UWCubeSat/bonk-electronics/containment-inter/ESQ-105-13-L-D.stp

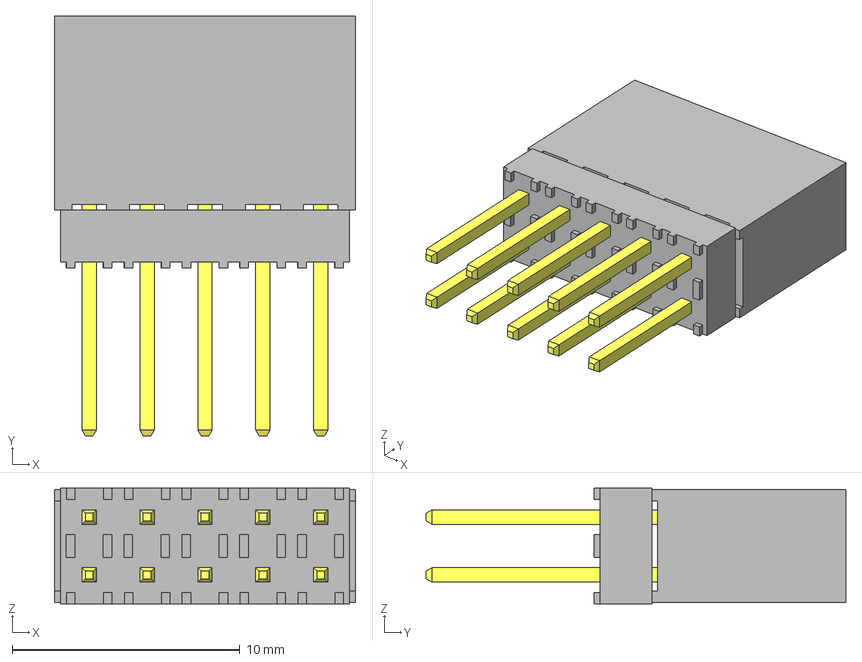
[picture p1: CAD file, 2020-08-15]
containment-inter/ESQ-105-13-L-D.stp
13.2 x 18.4 x 5.08 mm
_ESQ-105-13-L-D_socket
_ESQ-105-13-L-D_pins
_ESQ-105-13-G-D-LL_bpins
