UWCubeSat/bonk-electronics/spaceduino-dummy-experiment/usb-type-b.stp

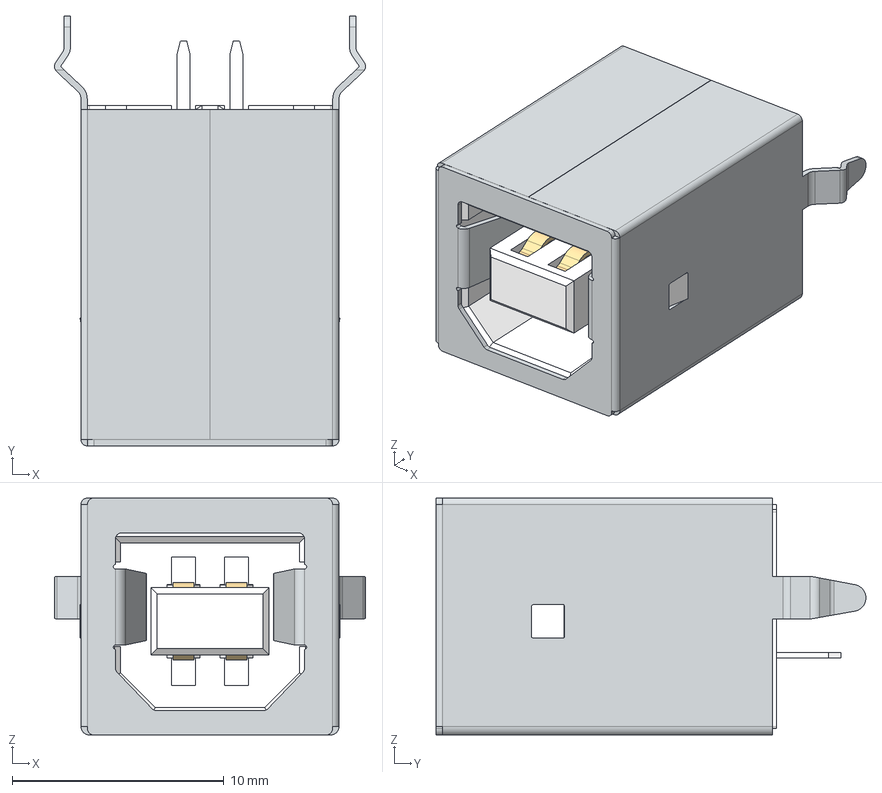
[picture p2: CAD file, 2020-07-03]
spaceduino-dummy-experiment/usb-type-b.stp
14.7 x 20.3 x 11.2 mm
61400413321_Insulator
61400413321_Pin x 2
61400413321_Pin_2 x 2
61400413321_Shielding
