UWCubeSat/bonk-electronics/spaceduino/spaceduino.kicad_pcb

## KiCad design spaceduino/spaceduino.kicad_pcb (2020-12-20)

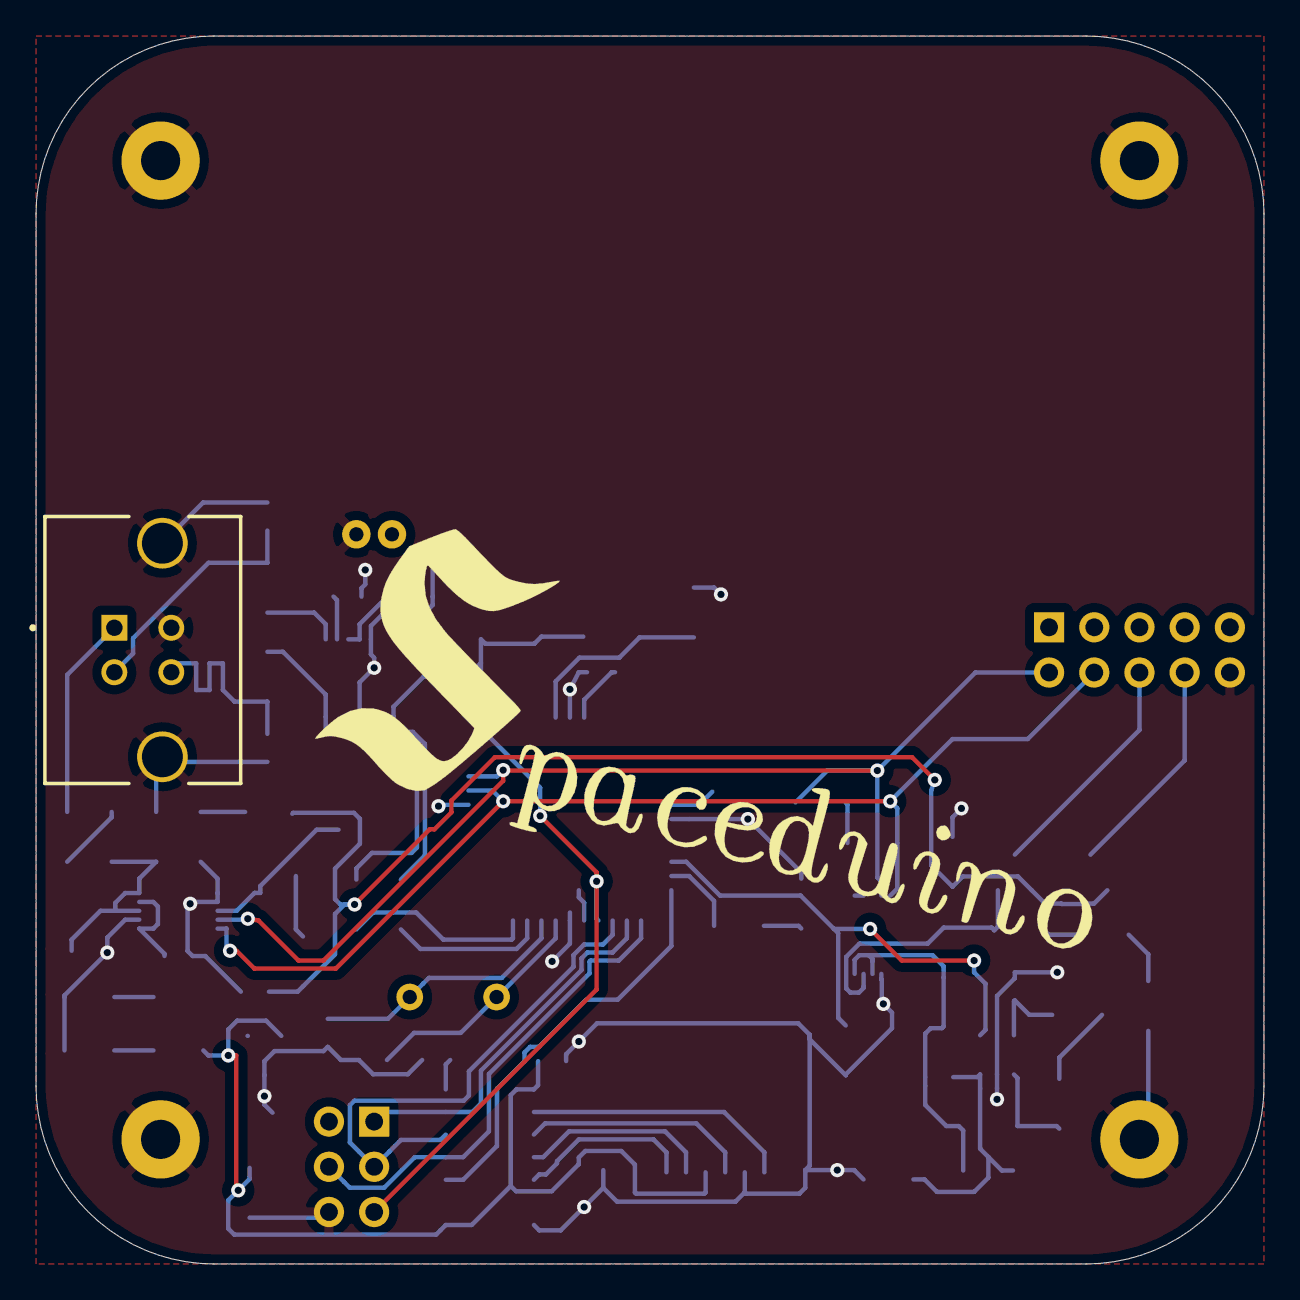
[picture p3: board spaceduino.kicad_pcb from above]

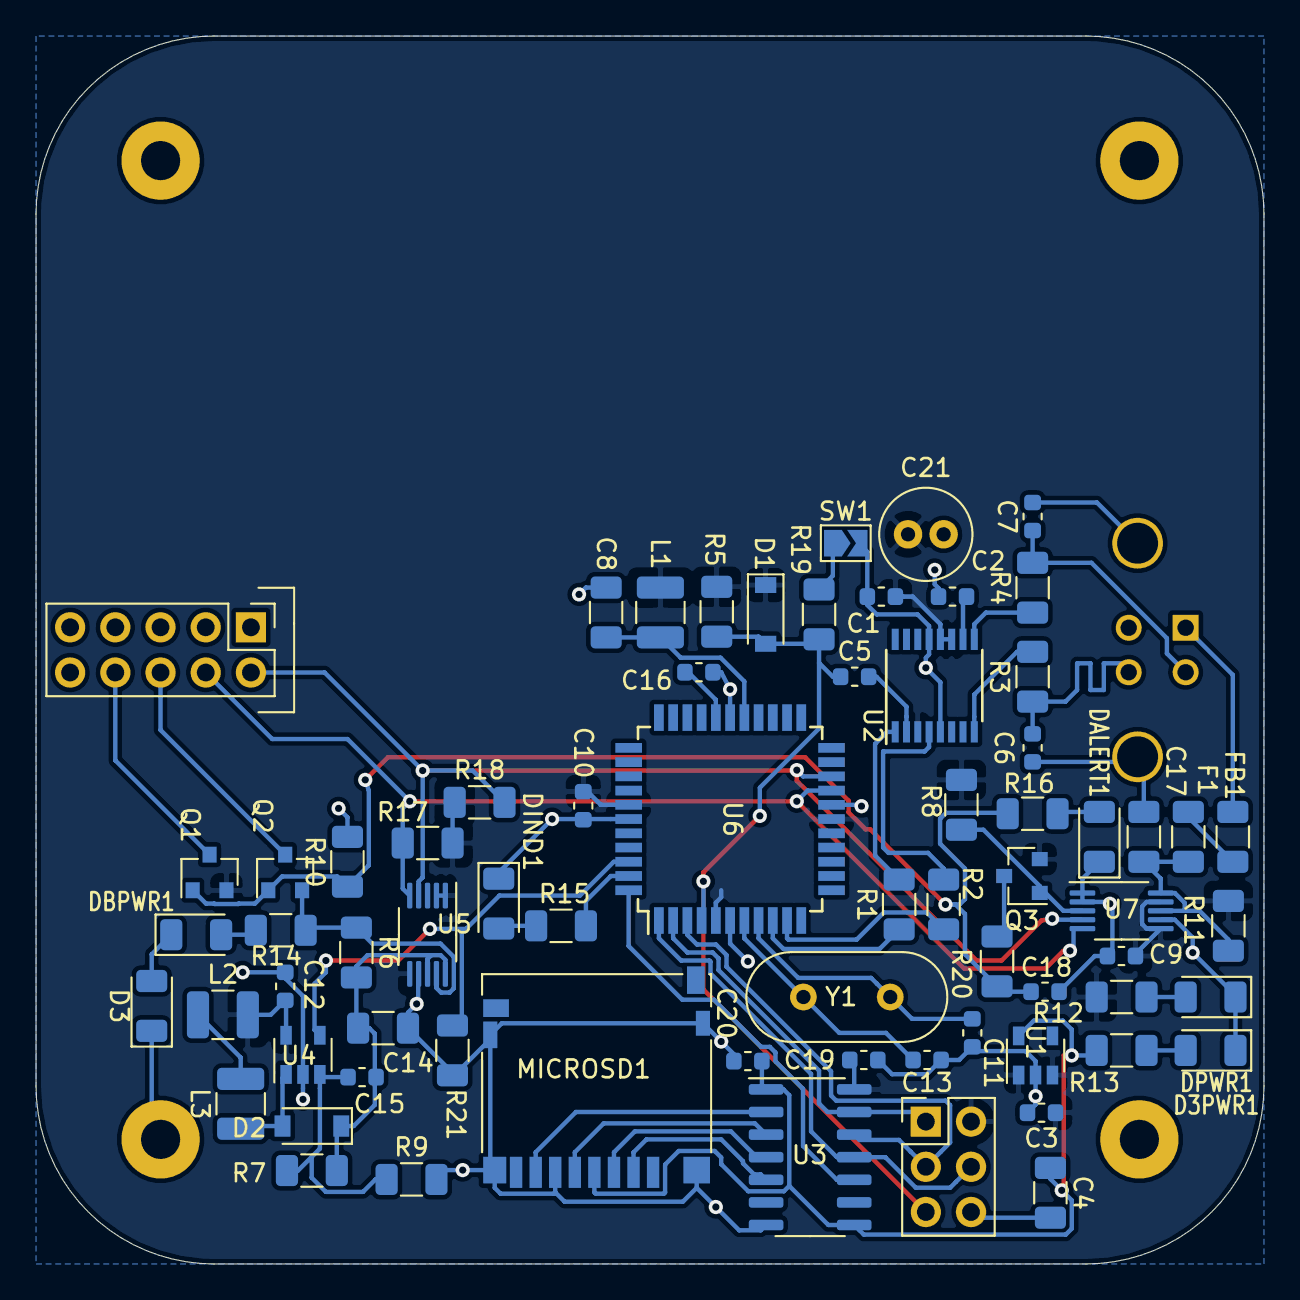
[picture p4: board spaceduino.kicad_pcb from below]

Board: 2 copper layers, 69.0 x 69.0 mm, 76 parts (70 on the bottom side), 50 nets.

Parts:
C1, C2, C3, C5, C9, C10, C12, C16, C19, C20: .1uF; C_0603_1608Metric
C4: 1uF; C_1206_3216Metric
C6, C7: 47pF; C_0603_1608Metric
C8, C14, C17: 10uF; C_1206_3216Metric
C11, C13: 22pF; C_0603_1608Metric
C15: 1.5nF; C_0603_1608Metric
C18: 10uF; C_0603_1608Metric
C21: 100uF; C_Radial_D5.0mm_H11.0mm_P2.00mm
D1: D; D_SOD-123
D2: D_Schottky; D_SOD-123
D3, D3PWR1: LED; LED_1206_3216Metric
DALERT1: LED; LED_1206_3216Metric
DBPWR1: LED; LED_1206_3216Metric
DIND1: LED; LED_1206_3216Metric
DPWR1: LED; LED_1206_3216Metric
F1: 1A; Fuse_1206_3216Metric
FB1: Ferrite_Bead; L_1206_3216Metric
H1, H2, H3, H4: MountingHole_Pad; MountingHole_2.2mm_M2_Pad
J1: USB_B; usb-type-b
J3: JICSP; PinHeader_2x03_P2.54mm_Vertical
J4: Conn_02x05_Odd_Even; PinHeader_2x05_P2.54mm_Vertical
L1: L; L_1210_3225Metric
L2, L3: 10uH; L_1210_3225Metric
LOGO1: Logo_Open_Hardware_Small; spaceduino-logo
MICROSD1: Micro_SD_Card_Det; microSD_HC_Hirose_DM3D-SF
Q1, Q2, Q3: BSS84; SOT-23
R1, R2: 1k; R_1206_3216Metric
R3, R4: 27; R_1206_3216Metric
R5, R8, R21: 10k; R_1206_3216Metric
R6, R11: 50m; R_1206_3216Metric
R7: 13k; R_1206_3216Metric
R9, R12, R15, R16: 1.5k; R_1206_3216Metric
R10: 36k; R_1206_3216Metric
R13: 470; R_1206_3216Metric
R14: 5.6k; R_1206_3216Metric
R17, R18: 3.3k; R_1206_3216Metric
R19, R20: 100; R_1206_3216Metric
SW1: SW_SPST; SolderJumper-2_P1.3mm_Open_TrianglePad1.0x1.5mm
U1: TLV70030_SOT23-5; SOT-23-5
U2: FT230XS; SSOP-16_3.9x4.9mm_P0.635mm
U3: TXB0104D; SOIC-14_3.9x8.7mm_P1.27mm
U4: LM27313XMF; SOT-23-5
U5, U7: INA226; VSSOP-10_3x3mm_P0.5mm
U6: ATmega1284P-AU; TQFP-44_10x10mm_P0.8mm
Y1: Crystal; Crystal_HC49-U_Vertical

Connections:
2_boost_en: R21.1, U4.4, U6.42
3: R15.1, U6.43
4_sd_ss: U3.10, U6.44
5_spi_mosi: J3.4, U3.11, U6.1
6_spi_miso: J3.1, U3.13, U6.2
7_spi_sck: J3.3, U3.12, U6.3
+3V0: C4.1, C20.1, MICROSD1.4, R13.1, U1.5, U3.1, U3.8
+5V: C1.1, C3.1, C9.1, C10.1, C12.1, C19.1, C21.1, D1.1, J3.2, L1.1, L2.2, Q1.2, Q3.2, R5.1, R8.1, R11.1, R12.1, R17.1, R18.1, U1.1, U1.3, U2.3, U2.11, U2.12, U3.14, U4.5, U5.1, U5.2, U5.6, U6.5, U6.17, U6.38, U7.6, U7.9
GND: C1.2, C2.1, C3.2, C4.2, C6.2, C7.2, C8.2, C9.2, C10.2, C11.2, C12.2, C13.2, C14.2, C16.2, C17.2, C18.2, C19.2, C20.2, C21.2, D3.1, D3PWR1.1, DALERT1.1, DIND1.1, DPWR1.1, H1.1, H2.1, H3.1, H4.1, J1.4, J1.5, J3.6, J4.10, MICROSD1.6, MICROSD1.11, R9.2, R10.2, R21.2, SW1.2, U1.2, U2.5, U2.13, U3.7, U4.2, U5.7, U6.6, U6.18, U6.28, U6.39, U7.1, U7.2, U7.7
unnamed: C2.2, U2.10
unnamed: C5.2, U2.2
unnamed: C8.1, L1.2, U6.27
unnamed: C11.1, U6.8, Y1.1
unnamed: C13.1, U6.7, Y1.2
unnamed: C14.1, C15.1, D2.1, R6.2, R7.1, U5.8, U5.10
unnamed: C15.2, R7.2, R9.1, U4.3
unnamed: C16.1, U6.29
unnamed: C17.1, F1.1, R11.2, U7.8, U7.10
unnamed: D2.2, L3.1, U4.1
unnamed: D3.2, DBPWR1.1
unnamed: D3PWR1.2, R13.2
unnamed: DALERT1.2, R16.2
unnamed: DBPWR1.2, R14.2
unnamed: DIND1.2, R15.2
unnamed: DPWR1.2, R12.2
unnamed: F1.2, FB1.2
unnamed: J4.6, Q2.3
unnamed: J4.8, Q1.3
unnamed: L2.1, L3.2
unnamed: MICROSD1.2, U3.5
unnamed: MICROSD1.3, U3.4
unnamed: MICROSD1.5, U3.3
unnamed: MICROSD1.7, U3.2
unnamed: Q3.1, R8.2, U7.3
unnamed: Q3.3, R20.2
unnamed: R1.2, U2.1
unnamed: R2.2, U2.4
unnamed: R3.1, U2.8
unnamed: R4.1, U2.9
unnamed: R19.1, SW1.1
VDDF: Q2.2, R6.1, R14.1, U5.9
current_trip: C18.1, Q1.1, Q2.1, R10.1, R16.1, R20.1
d+: C6.1, J1.3, R3.2
d-: C7.1, J1.2, R4.2
i2c_scl: J4.4, R17.2, U5.5, U6.19, U7.5
i2c_sda: J4.2, R18.2, U5.4, U6.20, U7.4
rxd0: R1.1, U6.9
txd0: R2.1, U6.10
vusb: FB1.1, J1.1
~reset: C5.1, D1.2, J3.5, R5.2, R19.2, U6.4
