UWCubeSat/bonk-electronics/containment-simple/containment-simple.kicad_pcb

## KiCad design containment-simple/containment-simple.kicad_pcb (2020-12-20)

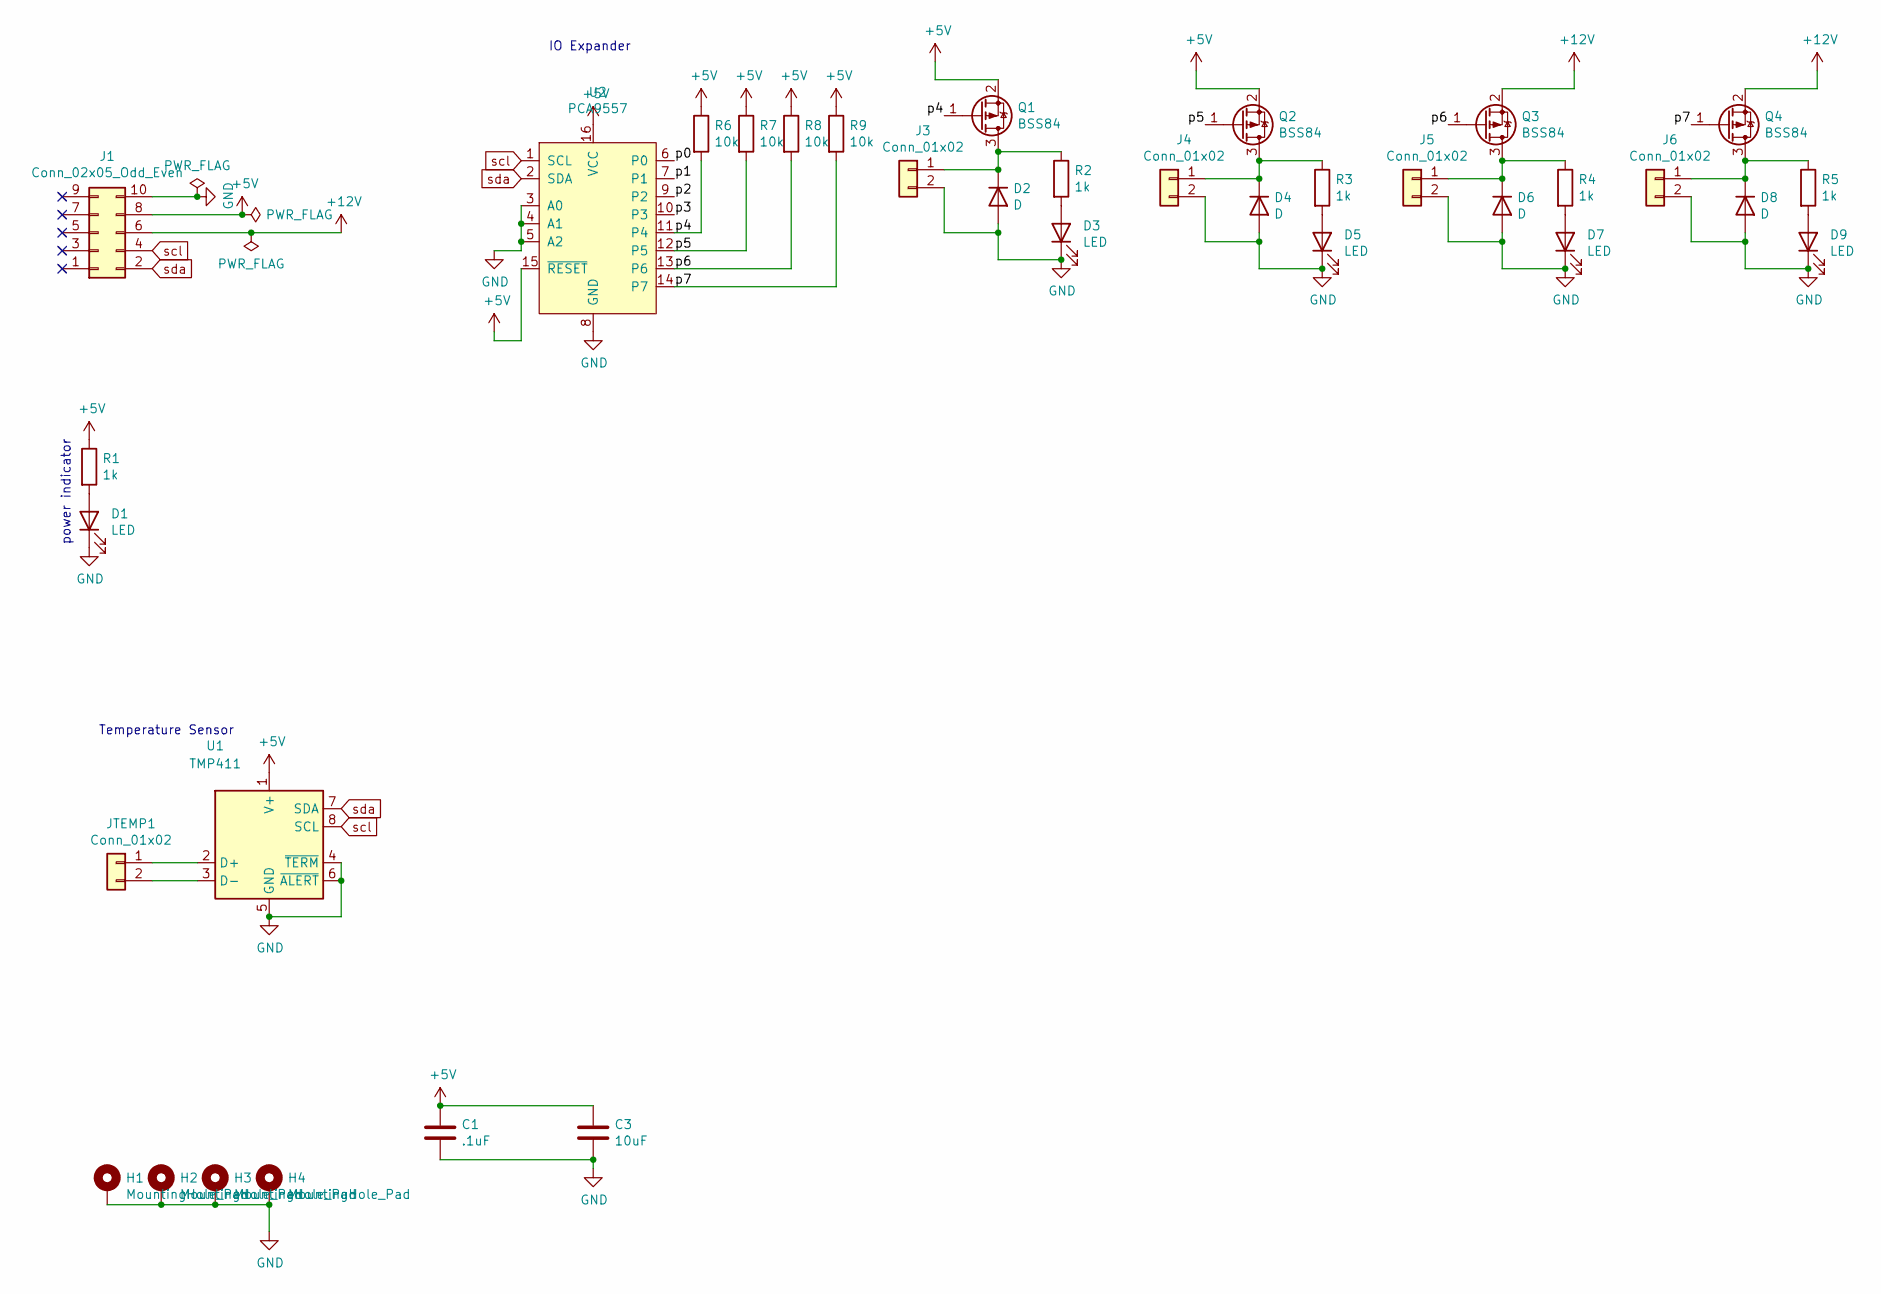
[picture p5: schematic containment-simple.sch]

Parts:
C1: .1uF; C_0603_1608Metric; LCSC C77055
C3: 10uF; C_1206_3216Metric; LCSC C14860
D1, D3, D5, D7, D9: LED; LED_1206_3216Metric; LCSC C264549
D2, D4, D6, D8: D; D_SOD-123; LCSC C222352
H1, H2, H3, H4: MountingHole_Pad; MountingHole_2-56_ExtraClearance
J1: Conn_02x05_Odd_Even; PinHeader_2x05_P2.54mm_Vertical
J3, J4, J5, J6: Conn_01x02; PinHeader_1x02_P2.54mm_Vertical
JTEMP1: Conn_01x02; PinHeader_1x02_P2.54mm_Vertical
Q1, Q2, Q3, Q4: BSS84; SOT-23; LCSC C508197
R1, R2, R3, R4, R5: 1k; R_0603_1608Metric; LCSC C50069
R6, R7, R8, R9: 10k; R_0603_1608Metric; LCSC C491175
U1: TMP411; VSSOP-8_3.0x3.0mm_P0.65mm; LCSC C475495
U2: PCA9557; TSSOP-16_4.4x5mm_P0.65mm; LCSC C141380

Connections:
+5V: C1.1, C3.1, J1.8, Q1.2 (S), Q2.2 (S), R1.1, R6.1, R7.1, R8.1, R9.1, U1.1 (V+), U2.15 (~RESET), U2.16 (VCC)
+12V: J1.6, Q3.2 (S), Q4.2 (S)
/p0: U2.6 (P0)
/p1: U2.7 (P1)
/p2: U2.9 (P2)
/p3: U2.10 (P3)
/p4: Q1.1 (G), R6.2, U2.11 (P4)
/p5: Q2.1 (G), R7.2, U2.12 (P5)
/p6: Q3.1 (G), R8.2, U2.13 (P6)
/p7: Q4.1 (G), R9.2, U2.14 (P7)
GND: C1.2, C3.2, D1.1 (K), D2.2 (A), D3.1 (K), D4.2 (A), D5.1 (K), D6.2 (A), D7.1 (K), D8.2 (A), D9.1 (K), H1.1, H2.1, H3.1, H4.1, J1.10, J3.2, J4.2, J5.2, J6.2, U1.4 (~TERM), U1.5 (GND), U1.6 (~ALERT), U2.3 (A0), U2.4 (A1), U2.5 (A2), U2.8 (GND)
unnamed: D1.2 (A), R1.2
unnamed: D2.1 (K), J3.1, Q1.3 (D), R2.1
unnamed: D3.2 (A), R2.2
unnamed: D4.1 (K), J4.1, Q2.3 (D), R3.1
unnamed: D5.2 (A), R3.2
unnamed: D6.1 (K), J5.1, Q3.3 (D), R4.1
unnamed: D7.2 (A), R4.2
unnamed: D8.1 (K), J6.1, Q4.3 (D), R5.1
unnamed: D9.2 (A), R5.2
unnamed: JTEMP1.1, U1.2 (D+)
unnamed: JTEMP1.2, U1.3 (D-)
scl: J1.4, U1.8 (SCL), U2.1 (SCL)
sda: J1.2, U1.7 (SDA), U2.2 (SDA)

Notes on the sheet:
power indicator
Temperature Sensor
IO Expander

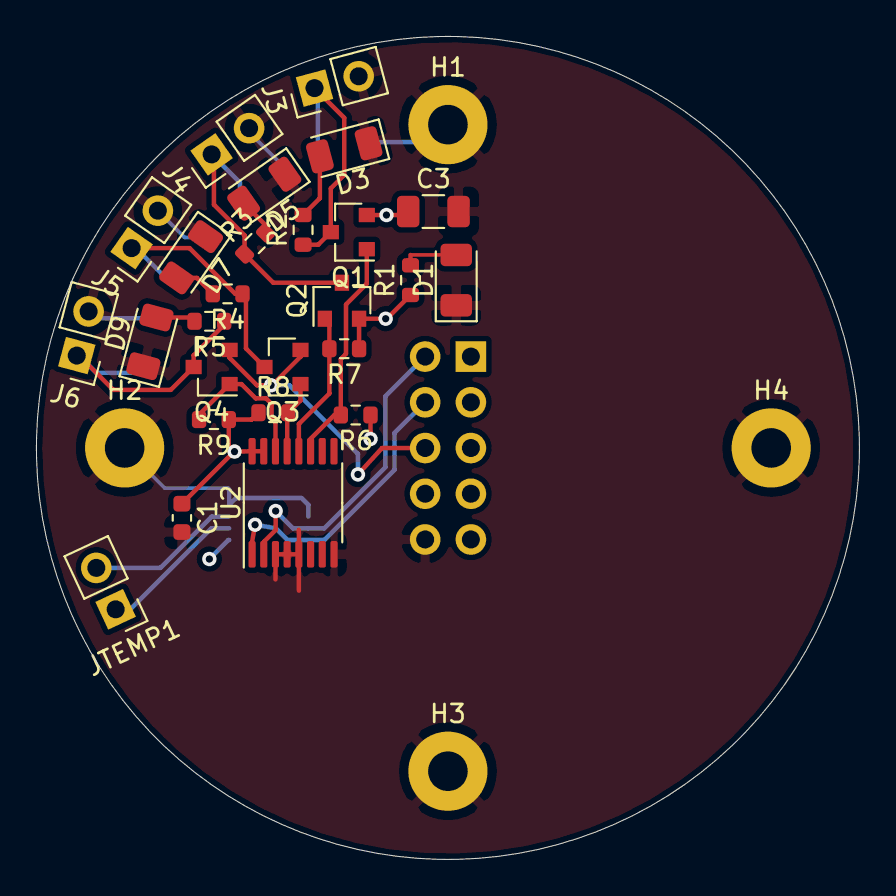
[picture p6: board containment-simple.kicad_pcb from above]

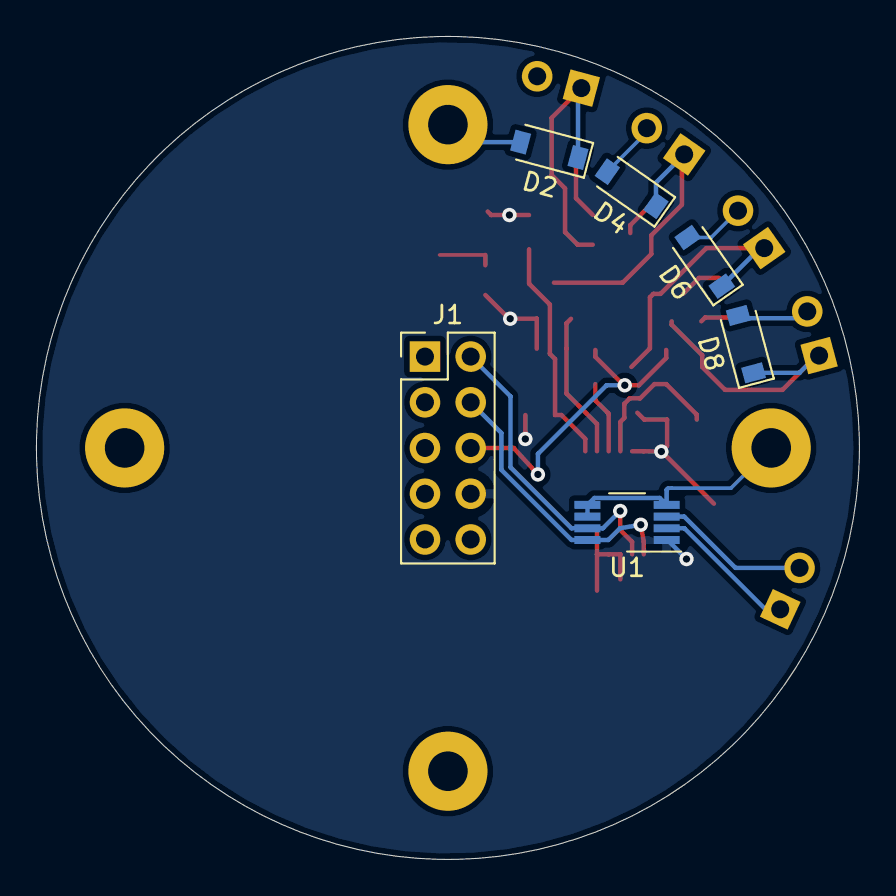
[picture p7: board containment-simple.kicad_pcb from below]

Board: 2 copper layers, 45.7 x 45.7 mm, 36 parts (6 on the bottom side), 20 nets.
