UWCubeSat/bonk-electronics/(commit log)

2020-07-27 containment inter
    [containment-inter.kicad_pcb, containment-inter.sch]
2020-07-27 containment simple mostly done
    [containment-simple.kicad_pcb, containment-simple.sch]
2020-07-27 spaceduino simple finished
    [spaceduino.kicad_pcb, spaceduino.sch]
2020-07-28 spaceduino Rev. 1
    [spaceduino.kicad_pcb, spaceduino.sch]
2020-07-28 jk, /this/ is the spaceduino 1.0! (actually, just look at git tags)
    [spaceduino.kicad_pcb, spaceduino.sch]
2020-07-28 ok, flipped a mosfet, NOW im done
    [spaceduino.kicad_pcb, spaceduino.sch]
2020-08-15 dummy experiment versions, set up .gitignore
    [ESQ-105-13-L-D.stp, containment-inter.kicad_pcb, containment-simple.kicad_pcb, containment-simple.sch, custom.sch, spaceduino.kicad_pcb, spaceduino.sch, usb-type-b.stp]
2020-12-20 some lcsc stuff
    [containment-simple.kicad_pcb, containment-simple.sch, spaceduino.kicad_pcb, spaceduino.sch]
2020-12-20 added that cool locking sd card footprint
2020-12-20 more lcsc, redo a lot of inner containment
    [containment-inter.kicad_pcb, containment-simple.kicad_pcb, containment-simple.sch, spaceduino.kicad_pcb, spaceduino.sch]
